cbares/modelidarust/doc/20260505_174503.jpg

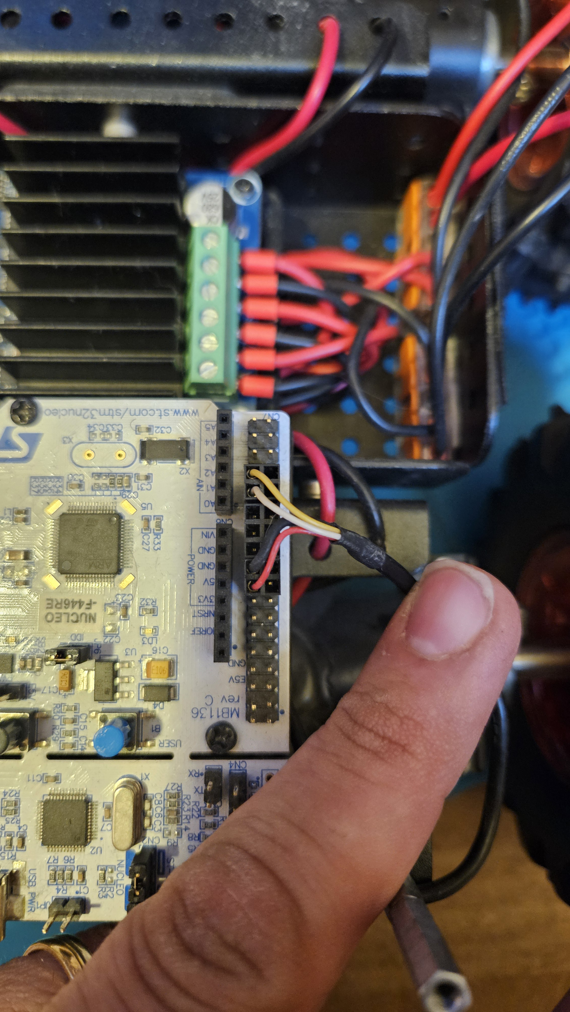
doc/20260505_174503.jpg
