cbares/modelidarust/doc/20260511_183049.jpg

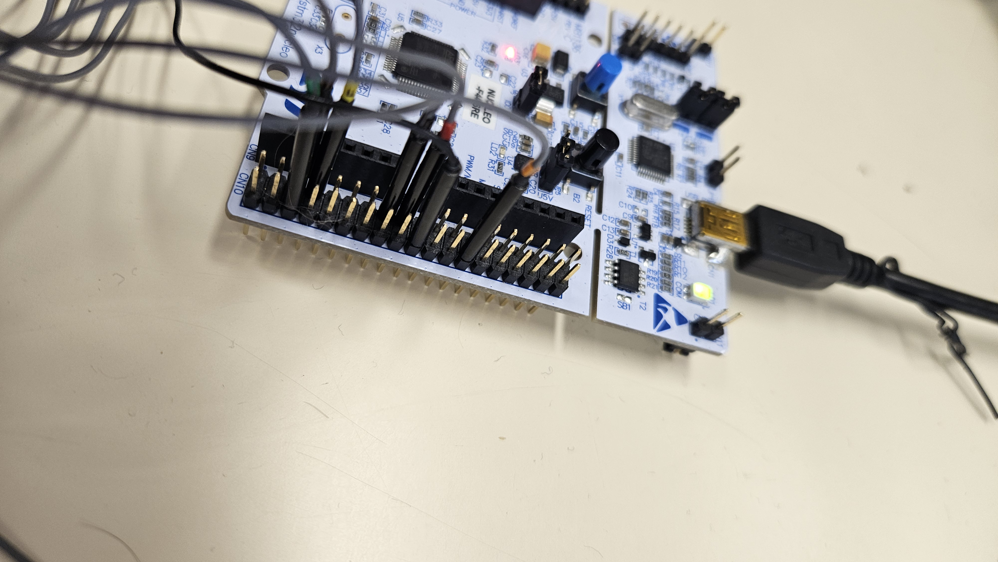
doc/20260511_183049.jpg
