cbares/modelidarust/pinouts/driver.png

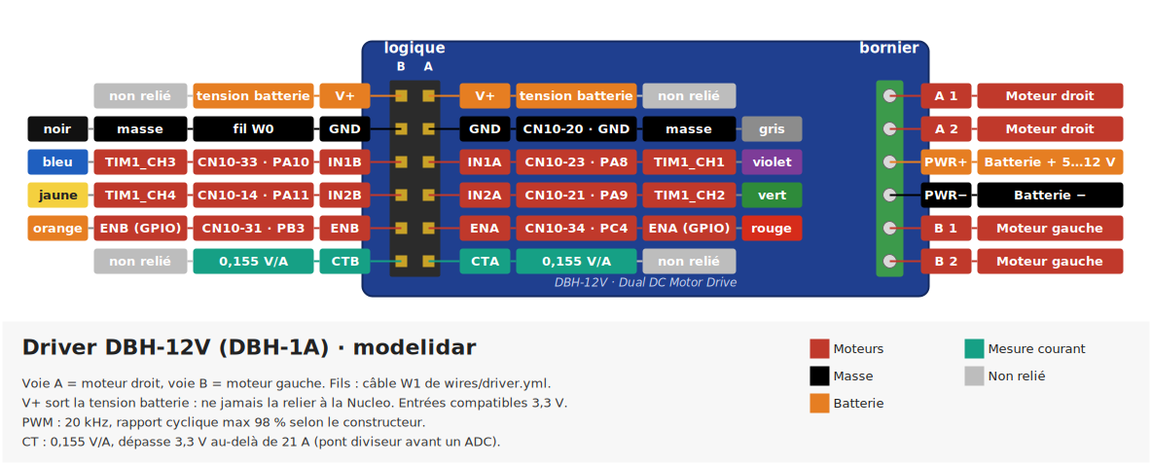
pinouts/driver.png
