cbares/modelidarust/pinouts/l476.png

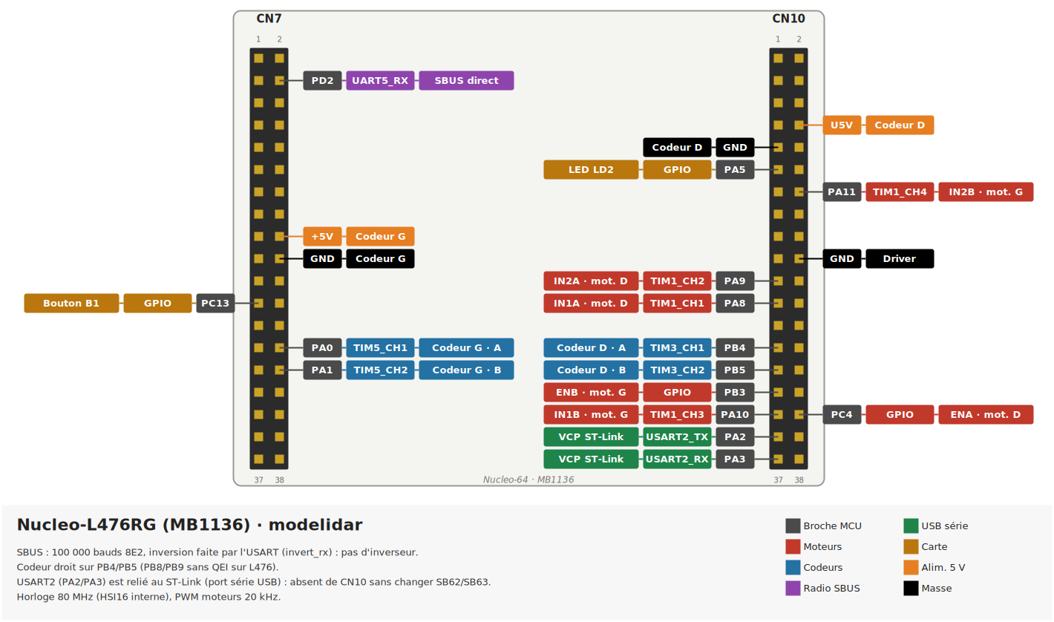
pinouts/l476.png
