cbares/modelidarust/wires/can.png

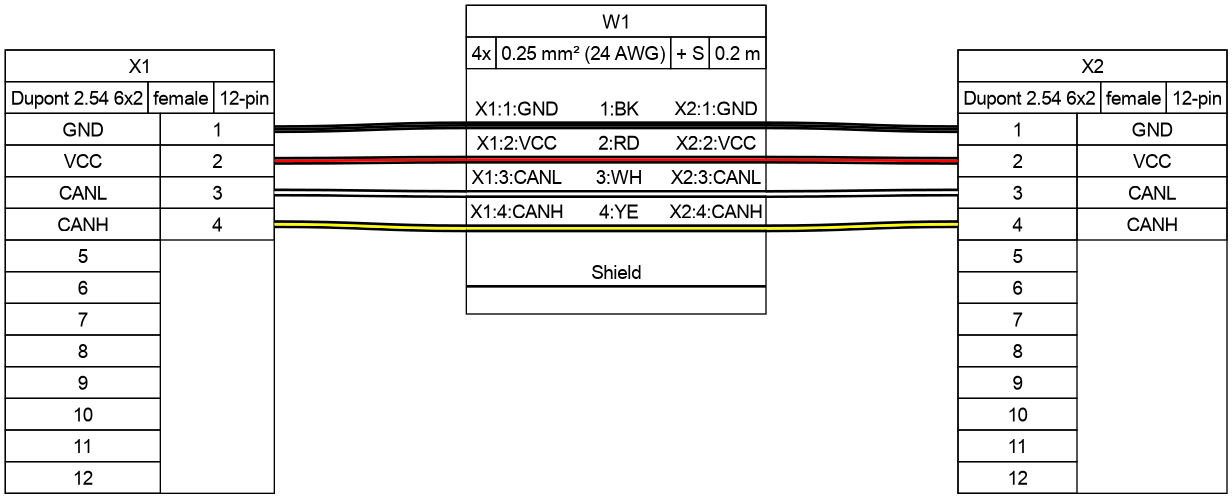
wires/can.png
