cbares/modelidarust/wires/driver.png

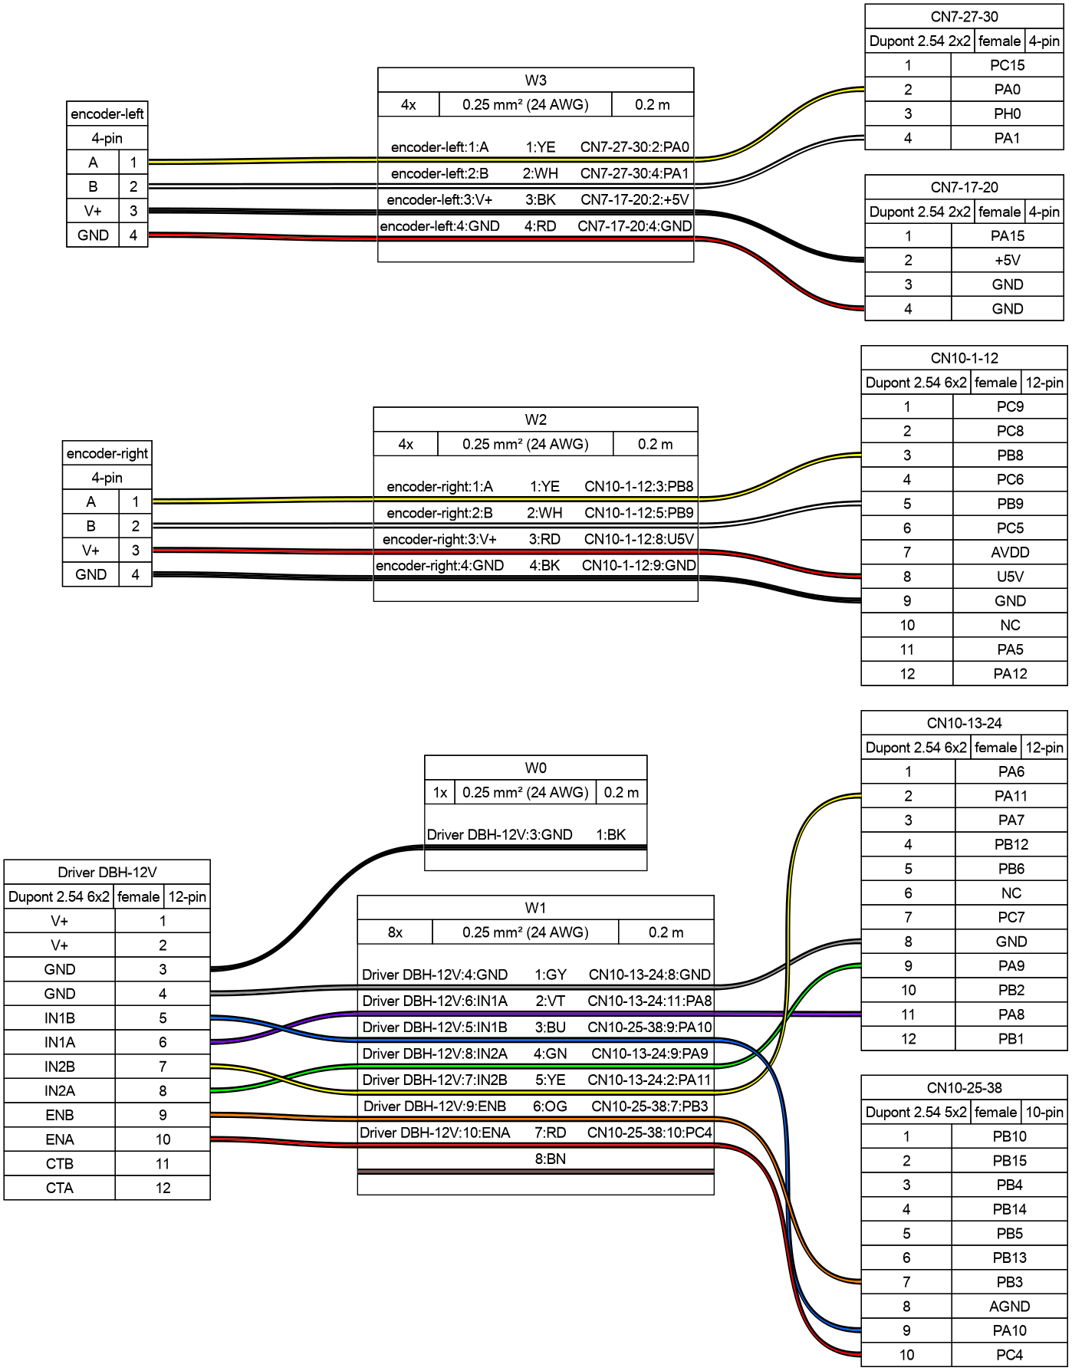
wires/driver.png
