cbares/modelidarust/(list of files, drawings)

Other design files:
doc/modelidar.fzz
