cbares/modelidarust/src/board/mod.rs

//! Configuration matérielle. Une seule carte est compilée, choisie par feature :
//! `stm32f446re` (par défaut), `stm32f411re` ou `stm32l476rg`.
//!
//! Chaque module de carte fournit `QeiLeft`, `QeiRight` et `Board::new()`.

#[cfg(any(
    all(feature = "stm32f446re", feature = "stm32f411re"),
    all(feature = "stm32f446re", feature = "stm32l476rg"),
    all(feature = "stm32f411re", feature = "stm32l476rg"),
))]
compile_error!("Activer une seule carte : `stm32f446re`, `stm32f411re` ou `stm32l476rg`.");
#[cfg(not(any(feature = "stm32f446re", feature = "stm32f411re", feature = "stm32l476rg")))]
compile_error!("Aucune carte activée : utiliser `stm32f446re`, `stm32f411re` ou `stm32l476rg`.");

#[cfg(feature = "stm32f446re")]
mod f446;
#[cfg(feature = "stm32f446re")]
pub use f446::{QeiLeft, QeiRight};

#[cfg(feature = "stm32f411re")]
mod f411;
#[cfg(feature = "stm32f411re")]
pub use f411::{QeiLeft, QeiRight};

#[cfg(feature = "stm32l476rg")]
mod l476;
#[cfg(feature = "stm32l476rg")]
pub use l476::{QeiLeft, QeiRight};

use defmt::info;
use embassy_stm32::Peri;
use embassy_stm32::gpio::{Input, Level, Output, OutputType, Pull, Speed};
use embassy_stm32::mode::Async;
use embassy_stm32::peripherals::{IWDG, PA8, PA9, PA10, PA11, PB3, PC4, TIM1};
use embassy_stm32::time::khz;
use embassy_stm32::timer::simple_pwm::{PwmPin, SimplePwm, SimplePwmChannel};
use embassy_stm32::usart::{Config as UartConfig, DataBits, Parity, StopBits, Uart, UartRx};
use motor_driver_hal::{MotorDriverBuilder, MotorDriverWrapper};

pub type MotorDriverType = MotorDriverWrapper<
    Output<'static>,
    Output<'static>,
    SimplePwmChannel<'static, TIM1>,
    SimplePwmChannel<'static, TIM1>,
>;

pub struct Board {
    pub led: Output<'static>,
    pub switch: Input<'static>,
    pub serial_usb: Uart<'static, Async>,
    pub qei_left: QeiLeft,
    pub qei_right: QeiRight,
    pub motor_left: MotorDriverType,
    pub motor_right: MotorDriverType,
    /// Rapport cyclique maximal des PWM moteurs (dépend de l'horloge de TIM1).
    pub max_duty: u16,
    pub sbus: UartRx<'static, Async>,
    pub iwdg: Peri<'static, IWDG>,
}

impl Default for Board {
    fn default() -> Self {
        Self::new()
    }
}

/// Liaison SBUS : 100 000 bauds, 8 bits, parité paire, 2 bits de stop, pull-up sur RX.
///
/// Le SBUS est un signal inversé. Les USART du F4 n'ont pas de bit RXINV
/// (`invert_rx` n'existe que sur F7, L4, G4, H7...) : sur F4, il faut ré-inverser
/// en amont, par un transistor ou la sortie « SBUS non inversé » du récepteur.
/// La carte L476 active `invert_rx` elle-même.
fn sbus_config() -> UartConfig {
    let mut config = UartConfig::default();
    config.baudrate = 100_000;
    config.data_bits = DataBits::DataBits8;
    config.parity = Parity::ParityEven;
    config.stop_bits = StopBits::STOP2;
    // Ligne au repos (haut) si le récepteur est débranché : pas de faux octets.
    config.rx_pull = Pull::Up;
    // Un overrun antérieur au démarrage de la lecture n'est pas une erreur.
    config.detect_previous_overrun = false;
    config
}

/// Moteurs sur TIM1 (PA8..PA11, 20 kHz) avec enables PC4 / PB3 :
/// brochage identique sur toutes les cartes.
///
/// Sur le robot, la voie A du driver est la roue droite et la voie B la roue gauche
/// (vérifié en essai : avec l'affectation inverse, le robot tournait à l'envers).
#[allow(clippy::too_many_arguments)]
fn init_motors(
    tim: Peri<'static, TIM1>,
    pa8: Peri<'static, PA8>,
    pa9: Peri<'static, PA9>,
    pa10: Peri<'static, PA10>,
    pa11: Peri<'static, PA11>,
    pc4: Peri<'static, PC4>,
    pb3: Peri<'static, PB3>,
) -> (MotorDriverType, MotorDriverType, u16) {
    let pwm = SimplePwm::new(
        tim,
        Some(PwmPin::new(pa8, OutputType::PushPull)),
        Some(PwmPin::new(pa9, OutputType::PushPull)),
        Some(PwmPin::new(pa10, OutputType::PushPull)),
        Some(PwmPin::new(pa11, OutputType::PushPull)),
        khz(20),
        Default::default(),
    );

    let ch = pwm.split();
    let mut in1a = ch.ch1; // PA8
    let mut in2a = ch.ch2; // PA9
    let mut in1b = ch.ch3; // PA10
    let mut in2b = ch.ch4; // PA11
    in1a.enable();
    in2a.enable();
    in1b.enable();
    in2b.enable();

    let max_duty = u16::try_from(in1a.max_duty_cycle()).expect("PWM max duty > u16");
    info!("PWM max duty: {}, frequency: {}", max_duty, in1a.get_frequency());

    let en_a = Output::new(pc4, Level::Low, Speed::Low); // ENA
    let en_b = Output::new(pb3, Level::Low, Speed::Low); // ENB

    // Voie B : roue gauche. Entrées croisées, le moteur est monté en miroir.
    let left = MotorDriverBuilder::new()
        .with_single_enable(en_b)
        .with_dual_pwm(in2b, in1b)
        .with_max_duty(max_duty)
        .build_and_init()
        .expect("Left Driver Motor problem");
    // Voie A : roue droite.
    let right = MotorDriverBuilder::new()
        .with_single_enable(en_a)
        .with_dual_pwm(in1a, in2a)
        .with_max_duty(max_duty)
        .build_and_init()
        .expect("Right Driver Motor problem");

    (left, right, max_duty)
}
