cbares/modelidarust/tools/teleop/src/protocol.rs

//! Protocole série du firmware (src/tasks/uart_usb.rs), utilisé tel quel.
//!
//! - `?`            état seul
//! - `#AAAA,BBBB`   consigne gauche, droite dans [0, 1000], 500 = arrêt
//! - `/`            arrêt (roue libre)
//! - `*`            freinage
//! - `V<g>,<d>\n`   vitesse des roues en mrad/s (régulée par le firmware)
//! - `K\n`          lit les gains, `K<kp>,<ki>,<kff>,<dmin>\n` les change
//!   (réponse `K:kp,ki,kff,dmin` au lieu de l'état)
//!
//! Réponse : `!AAAA,BBBB L:vit,pos R:vit,pos C:<pilote> F:<défaut>`

/// Consigne neutre du protocole.
pub const ZERO: i32 = 500;

/// Mesure d'une roue.
#[derive(Debug, Clone, Copy, PartialEq)]
pub struct Wheel {
    /// Pas codeur par seconde.
    pub velocity: f32,
    /// Position cumulée, en pas codeur.
    pub position: i32,
}

/// Réponse décodée de la carte.
#[derive(Debug, Clone, PartialEq)]
pub struct Reply {
    /// Consigne appliquée, centrée : [-ZERO, ZERO].
    pub alpha: (i32, i32),
    pub left: Wheel,
    pub right: Wheel,
    /// Qui pilote : USB, RC ou LOST.
    pub owner: String,
    /// Défaut actif : -, USB_TIMEOUT ou STALL.
    pub fault: String,
}

/// Décode une ligne de réponse, ou `None` si ce n'en est pas une.
pub fn parse(line: &str) -> Option<Reply> {
    let mut fields = line.trim().strip_prefix('!')?.split(' ');
    let (al, ar) = fields.next()?.split_once(',')?;
    let left = wheel(fields.next()?.strip_prefix("L:")?)?;
    let right = wheel(fields.next()?.strip_prefix("R:")?)?;
    let owner = fields.next()?.strip_prefix("C:")?.to_string();
    let fault = fields.next()?.strip_prefix("F:")?.to_string();
    if fields.next().is_some() {
        return None;
    }
    Some(Reply {
        alpha: (al.parse::<i32>().ok()? - ZERO, ar.parse::<i32>().ok()? - ZERO),
        left,
        right,
        owner,
        fault,
    })
}

fn wheel(field: &str) -> Option<Wheel> {
    let (v, p) = field.split_once(',')?;
    Some(Wheel { velocity: v.parse().ok()?, position: p.parse().ok()? })
}

/// Trame de consigne avec mixage « arcade », comme la radiocommande :
/// gauche = avance + direction, droite = avance - direction.
pub fn speed_frame(throttle: i32, steer: i32) -> String {
    let left = (throttle + steer).clamp(-ZERO, ZERO);
    let right = (throttle - steer).clamp(-ZERO, ZERO);
    format!("#{:04},{:04}", left + ZERO, right + ZERO)
}

/// Trame de consigne de vitesse, avec le même mixage : avance et direction en tr/s.
pub fn velocity_frame(throttle_rps: f32, steer_rps: f32) -> String {
    let mrad = |rps: f32| (rps * std::f32::consts::TAU * 1000.0).round() as i32;
    format!("V{},{}\n", mrad(throttle_rps + steer_rps), mrad(throttle_rps - steer_rps))
}

/// Gains renvoyés par la carte : `K:kp,ki,kff,dmin`.
pub fn parse_gains(line: &str) -> Option<[f32; 4]> {
    let mut out = [0.0; 4];
    let mut fields = line.trim().strip_prefix("K:")?.split(',');
    for v in out.iter_mut() {
        *v = fields.next()?.parse().ok()?;
    }
    fields.next().is_none().then_some(out)
}

#[cfg(test)]
mod tests {
    use super::*;

    #[test]
    fn parse_reply() {
        let r = parse("!0700,0600 L:+600.5,+420 R:-3,-210 C:USB F:-\r").unwrap();
        assert_eq!(r.alpha, (200, 100));
        assert_eq!(r.left, Wheel { velocity: 600.5, position: 420 });
        assert_eq!(r.right, Wheel { velocity: -3.0, position: -210 });
        assert_eq!(r.owner, "USB");
        assert_eq!(r.fault, "-");
    }

    #[test]
    fn parse_fault_and_owner() {
        let r = parse("!0500,0500 L:+0,+0 R:+0,+0 C:LOST F:USB_TIMEOUT").unwrap();
        assert_eq!(r.owner, "LOST");
        assert_eq!(r.fault, "USB_TIMEOUT");
    }

    #[test]
    fn reject_other_lines() {
        assert_eq!(parse("MCU started"), None);
        assert_eq!(parse("!0500,0500 L:+0,+0 R:+0,+0 C:USB"), None);
        assert_eq!(parse("!0500,0500 L:x,+0 R:+0,+0 C:USB F:-"), None);
    }

    #[test]
    fn velocity_frames() {
        assert_eq!(velocity_frame(0.0, 0.0), "V0,0\n");
        assert_eq!(velocity_frame(0.5, 0.0), "V3142,3142\n");
        assert_eq!(velocity_frame(0.0, 0.25), "V1571,-1571\n");
    }

    #[test]
    fn gains() {
        assert_eq!(parse_gains("K:0.05,0.5,0.05,0.2\r"), Some([0.05, 0.5, 0.05, 0.2]));
        assert_eq!(parse_gains("K:0.05,0.5"), None);
        assert_eq!(parse_gains("MCU started"), None);
    }

    #[test]
    fn frames() {
        assert_eq!(speed_frame(0, 0), "#0500,0500");
        assert_eq!(speed_frame(150, 50), "#0700,0600");
        assert_eq!(speed_frame(500, 500), "#1000,0500");
        assert_eq!(speed_frame(-500, 200), "#0200,0000");
    }
}
