cbares/modelidarust/(commit log)

2026-05-03 Uart and qei ok
    [modelidar.fzz]
2026-10-25 Add driver and connector definitions in YAML configuration
    - Introduced new connectors including Driver, CN10-1-12, CN10-13-24, CN10-25-38, CN7-17-20, CN7-27-30, encoder-right, and encoder-left with respective pin counts and labels.
    - Defined cable specifications for W0, W1, W2, and W3 including gauge, length, color codes, and wire counts.
    - Established connections between drivers, cables, and connectors to facilitate wiring configuration.
2026-10-25 correction débordement odometrie
2026-10-26 Split board support per chip and add Nucleo-F411RE
    - src/board/ now holds the shared Board struct and motor setup (mod.rs)
    plus one module per chip (f446.rs, f411.rs), selected by feature.
    - Each board exposes QeiLeft/QeiRight type aliases, so the odometry task
    no longer needs a macro and nested cfg_select! over qei-timX features.
    - Drop the qei-timX and stm32f410rb features; refuse to build with zero or
    several boards enabled.
    - Pass the PWM max duty to the motors task instead of hardcoding 9000
    (F411 TIM1 runs at 100 MHz: max duty 5000 at 20 kHz).
    - probe-rs chip now comes from PROBE_RS_CHIP (default STM32F446RE).
    - F411 pinout: left encoder on TIM3 PB4/PB5, SBUS on USART6 PC7.
    Co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
    [f411.rs, f446.rs, main.rs, mod.rs, motors.rs, odometry.rs]
2026-10-26 Let the SBUS RC receiver take over from USB control
    - New sbus task: frames decoded with sbus-rs, with a frame sync that is
    only confirmed by the next frame header (a stray 0x0F in the data could
    otherwise yield a false frame). Link is lost on receiver failsafe or
    after 100 ms without a valid frame.
    - Arbitration lives in motors::arbitrate: CH5 high gives control to the
    RC (arcade mix on CH1/CH2); releasing it stops the motors and gives
    control back to USB; losing the radio while in control stops the motors
    and keeps USB locked out until the radio is back with CH5 released.
    - Serial reply now reports the command actually applied and ends with
    C:USB, C:RC or C:LOST.
    - SBUS UART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
    [f411.rs, f446.rs, main.rs, mod.rs, motors.rs, sbus.rs, state.rs]
2026-10-26 Add Nucleo-L476RG board
    - 80 MHz from HSI16 (no dependency on the ST-Link MCO clock), TIM1 at
    80 MHz: max duty 4000 at 20 kHz.
    - Left encoder on TIM3 PB4/PB5, right encoder on TIM5 PA0/PA1.
    - SBUS on UART5 PD2 with invert_rx: the L4 USART inverts the signal
    itself, no external inverter needed.
    - New stm32l476rg feature, flash with PROBE_RS_CHIP=STM32L476RG.
    [l476.rs, mod.rs]
2026-10-26 Add Motor Driver Pinout
2026-10-26 fix ticks per rev
    [motors.rs, odometry.rs, uart_usb.rs]
2026-10-26 fix bugs on motors directions
    [driver.py, f411.py, f411.rs, f446.py, f446.rs, l476.py, l476.rs, main.rs]
2026-10-26 add PI loop on motors
2026-10-26 fix timeout on # frames
    [uart_usb.rs]
2026-10-26 clarify UART task behavior
