cbares/modelidarust/doc/20260505_174448.jpg

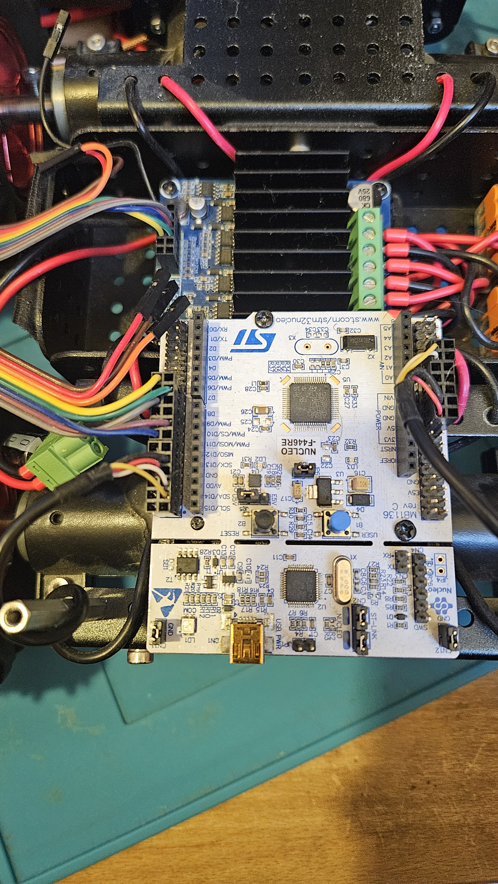
doc/20260505_174448.jpg
