cbares/modelidarust/doc/20260505_174455.jpg

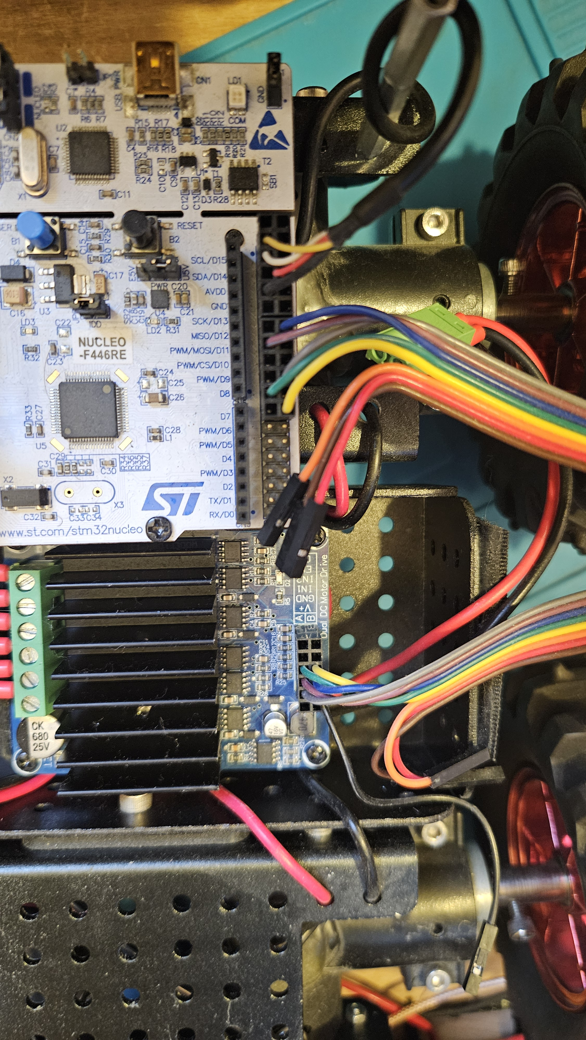
doc/20260505_174455.jpg
