cbares/modelidarust/doc/20260505_174508.jpg

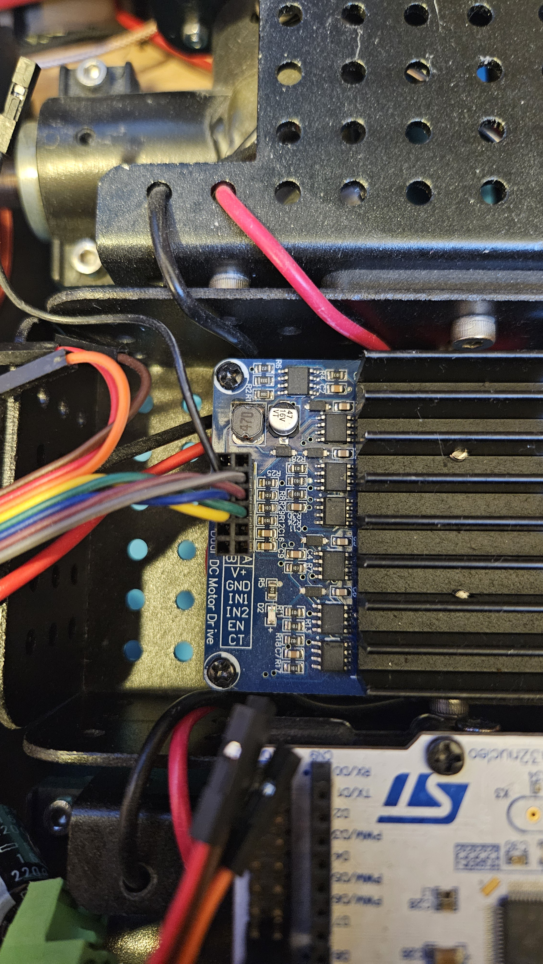
doc/20260505_174508.jpg
