cbares/modelidarust/doc/20260511_210523.jpg

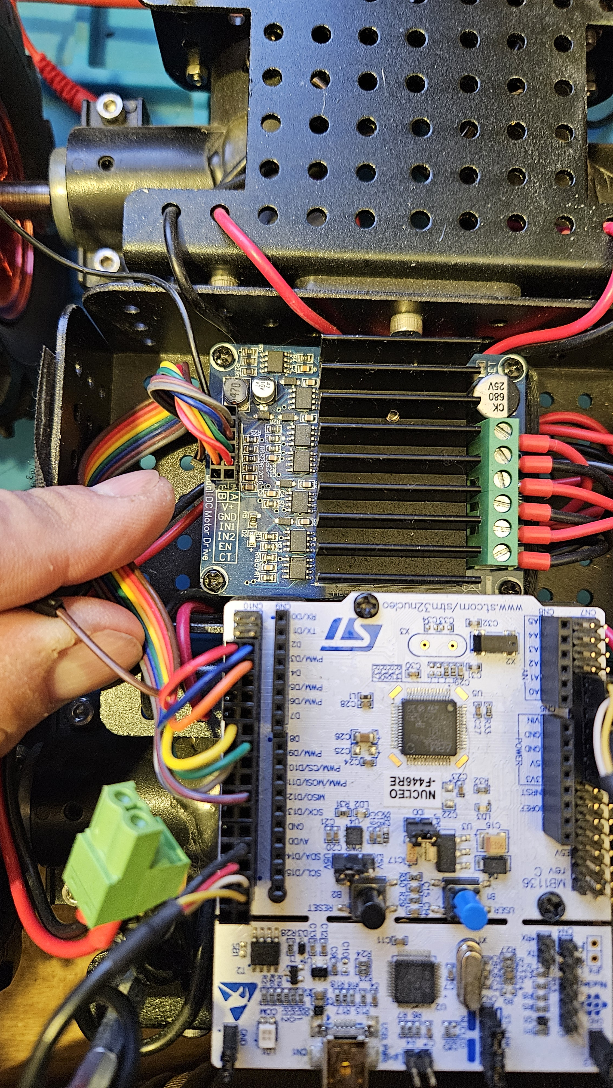
doc/20260511_210523.jpg
