cbares/modelidarust/doc/20260511_210529.jpg

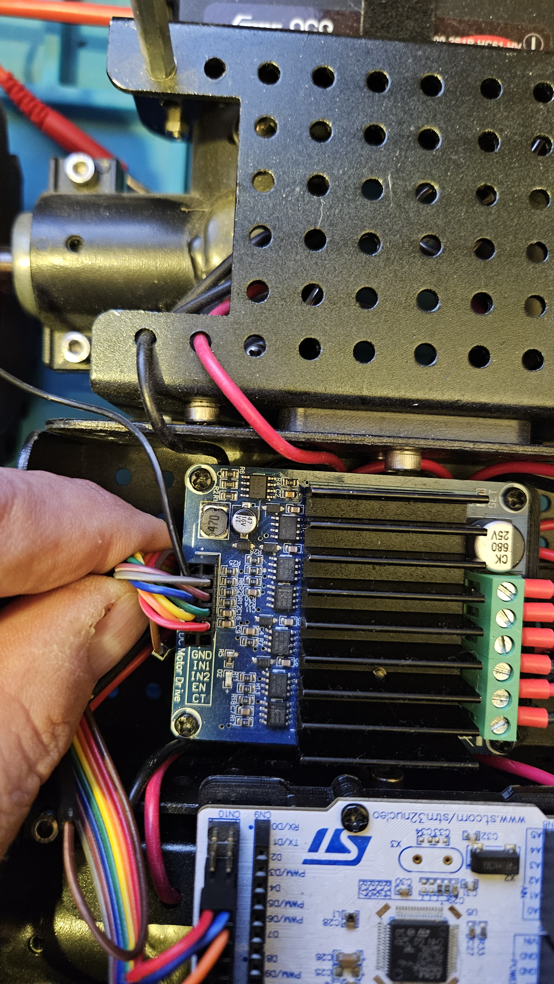
doc/20260511_210529.jpg
